ymmtr6/agent-pad/docs/JLCPCB_REPLACEMENT_REV1_CONTINUOUS_20260821.md

# JLCPCB Rev.1 continuous-outline replacement

Target engineer question: `13307549A-Y2`

Upload:

`manufacturing/agentpad_rev1_JLCPCB_panel_replacement_continuous_20260821.zip`

## Correction

- All functional-board and spacer cutting lines are fully connected closed loops.
- No intentional cutting-line gap remains at the former breakaway-tab positions.
- The 152 x 88 mm panel and 68 x 80 mm functional-board dimensions are unchanged.
- Copper, solder mask, paste, silkscreen, and plated-drill files are byte-for-byte identical to the ordered Rev.1 data.
- Only `agentpad_rev1_panel-Edge_Cuts.gbr` is replaced.
- Switch, encoder, RP2040-Zero, and spacer openings are unchanged.

Because the customer data no longer contains retention gaps, JLCPCB CAM should add any temporary production retention tabs needed during routing.

## Validation

- KiCad 9.0.8 standard DRC: lower PCB 0 violations / 0 unconnected; upper PCB 0 violations / 0 unconnected.
- Generator geometry checks: PASS.
- Edge-Cuts graph: 3,080 segments, 64 closed components, 0 odd-degree vertices, 0 duplicate segments.
- ZIP integrity: PASS (8 files).
- SHA-256: `3aede9918c3693d0929e213fe15ce22cecbfcb6f1535e165b50939c38517ad8c`

Final manufacturability remains subject to JLCPCB CAM approval.
