ymmtr6/agent-pad/firmware/readme_rev3.md

# QMK wiring

Direct GPIOs: GP0..GP5 = K1..K6, GP8 = encoder A, GP14 = encoder B, GP15 = encoder push.
All inputs active-low with internal pull-ups.
On-board RP2040-Zero RGB is GPIO16.
