ymmtr6/agent-pad/docs/images/rev2_kicad_bottom.png

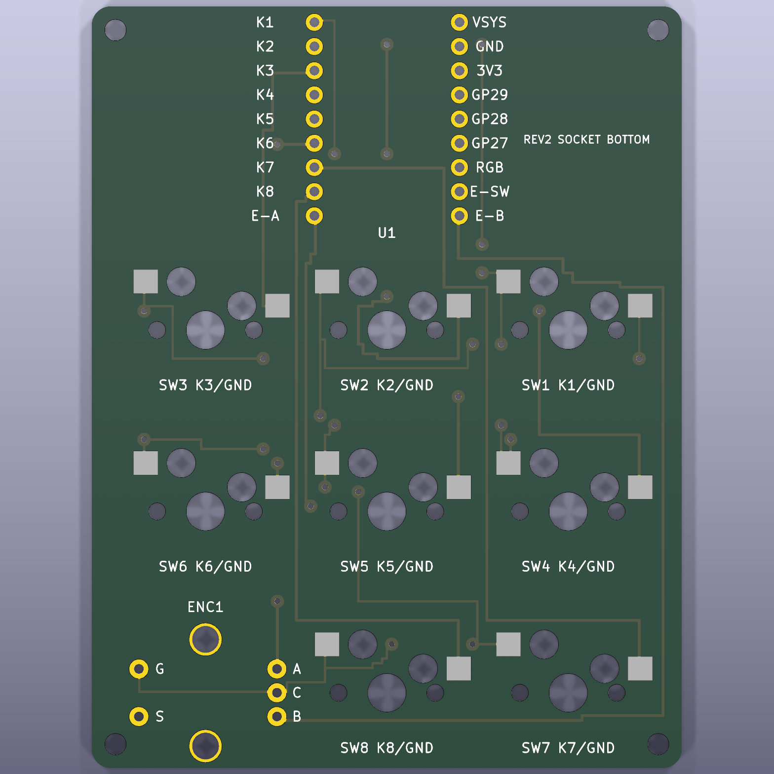
docs/images/rev2_kicad_bottom.png
