ymmtr6/agent-pad/docs/images/rev2_kicad_perspective.png

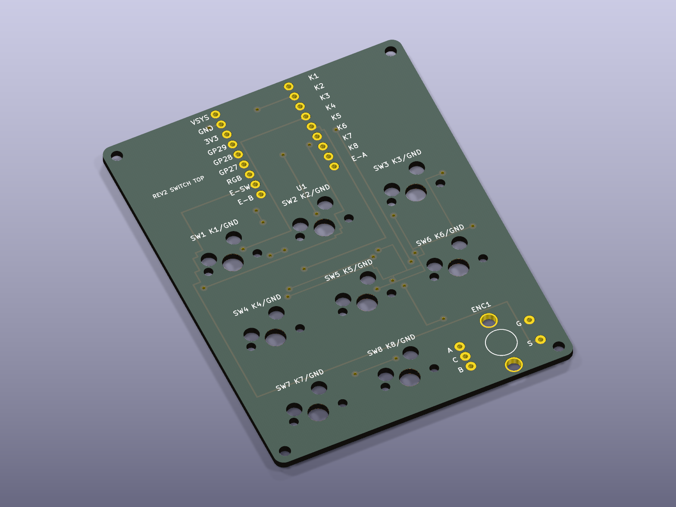
docs/images/rev2_kicad_perspective.png
