ymmtr6/agent-pad/cad/keycap_cherry_mx/agentpad_sw2_task2.stl

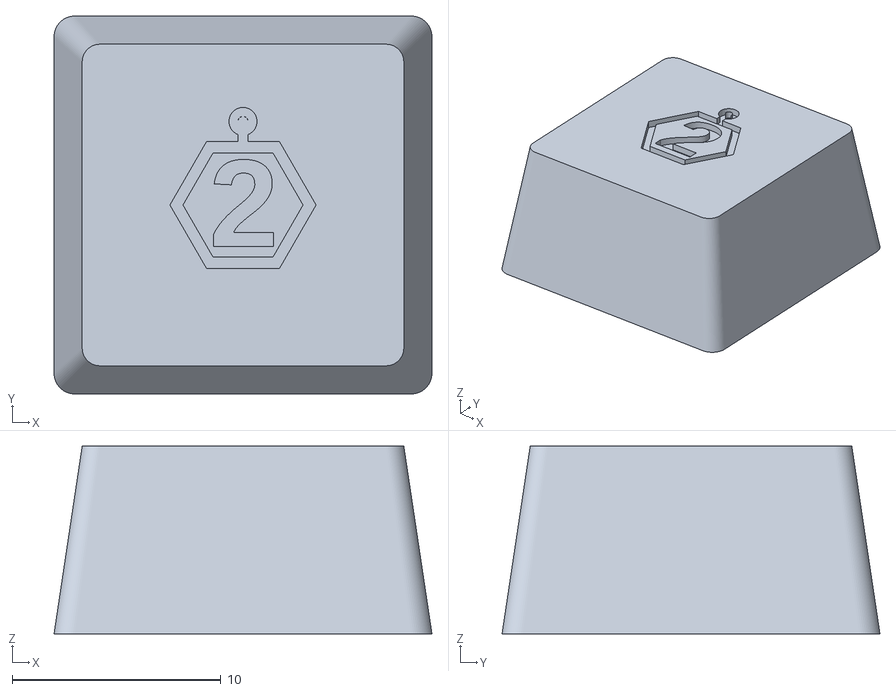
[picture p4: CAD file, 2026-10-14]
cad/keycap_cherry_mx/agentpad_sw2_task2.stl
18.1 x 18.1 x 9.00
