ymmtr6/agent-pad/cad/rev2_case/insert_test.stl

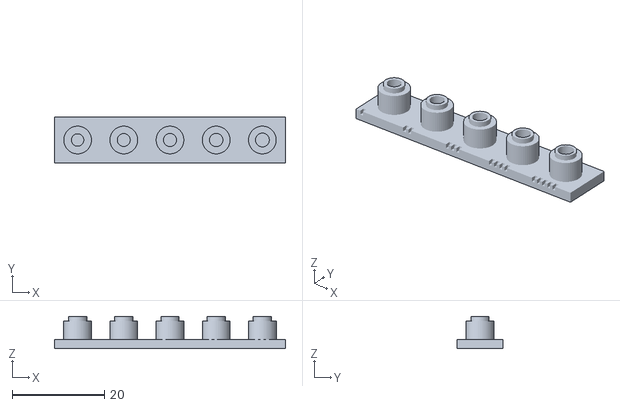
[picture p5: CAD file, 2026-10-14]
cad/rev2_case/insert_test.stl
50.0 x 10.0 x 7.00
