ymmtr6/agent-pad/cad/rev2_case/plate_fit_test.stl

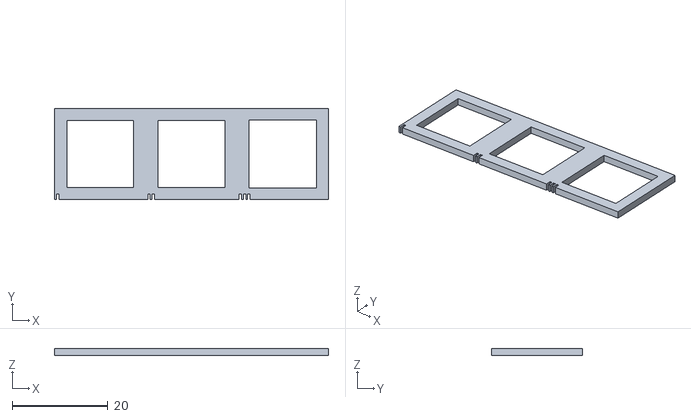
[picture p6: CAD file, 2026-10-14]
cad/rev2_case/plate_fit_test.stl
57.1 x 19.0 x 1.50
