ymmtr6/agent-pad/cad/rev2_case/plate.stl

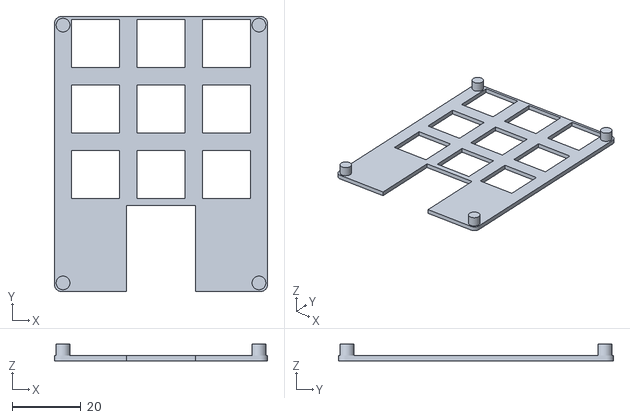
[picture p7: CAD file, 2026-10-14]
cad/rev2_case/plate.stl
62.0 x 80.0 x 4.80
