ymmtr6/agent-pad/cad/rev2_case/bottom_insert.stl

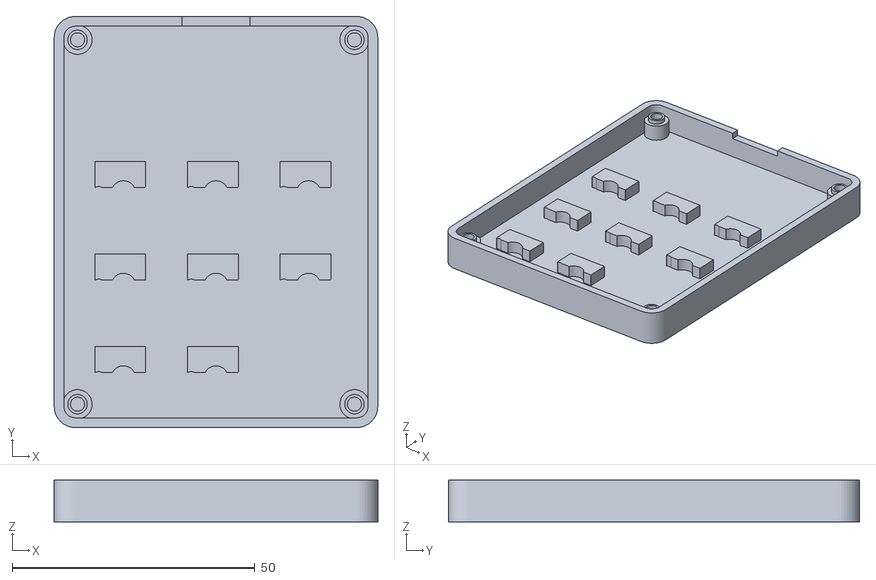
[picture p8: CAD file, 2026-10-14]
cad/rev2_case/bottom_insert.stl
66.6 x 84.6 x 8.60
