ymmtr6/agent-pad/cad/keycap_cherry_mx/agentpad_keyset_8.stl

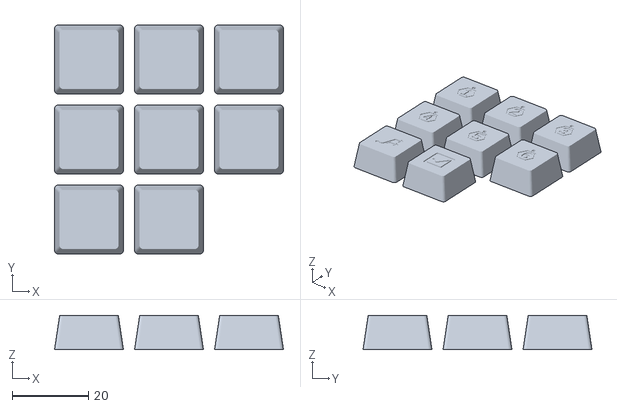
[picture p9: CAD file, 2026-10-14]
cad/keycap_cherry_mx/agentpad_keyset_8.stl
60.1 x 60.1 x 9.00
