ymmtr6/agent-pad/cad/keycap_cherry_mx/cherry_mx_fit_test.stl

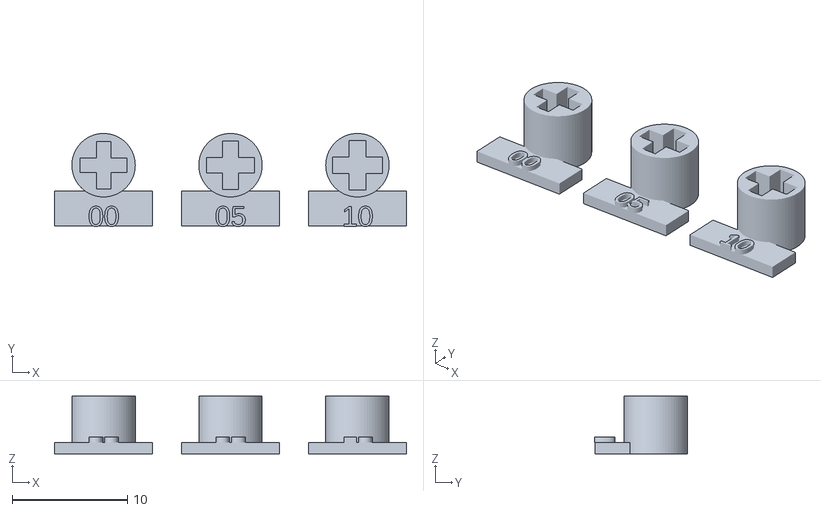
[picture p10: CAD file, 2026-10-14]
cad/keycap_cherry_mx/cherry_mx_fit_test.stl
30.5 x 8.06 x 5.00
