ymmtr6/agent-pad/(list of files, cad)

Other CAD files:
cad/keycap_cherry_mx/agentpad_sw8_test.stl
cad/keycap_cherry_mx/cherry_mx_1u_blank.stl
cad/keycap_cherry_mx/agentpad_sw3_task3.stl
cad/keycap_cherry_mx/cherry_mx_1u_keycap.stl
cad/rev2_case/bottom.stl
cad/keycap_cherry_mx/agentpad_sw5_task5.stl
cad/keycap_cherry_mx/agentpad_sw6_task6.stl
cad/keycap_cherry_mx/agentpad_sw7_refactor.stl
cad/keycap_cherry_mx/agentpad_sw4_task4.stl
cad/keycap_cherry_mx/agentpad_sw1_task1.stl
