ymmtr6/agent-pad/docs/images/rev2_assembly_case_concept.png

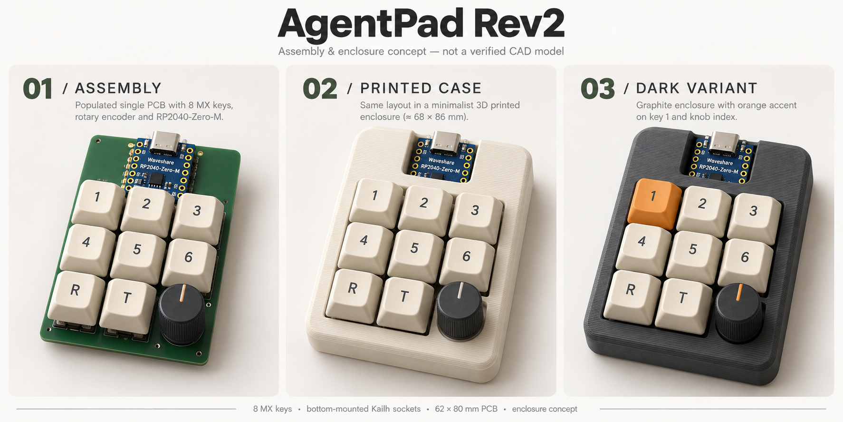
docs/images/rev2_assembly_case_concept.png
