ymmtr6/agent-pad/docs/VALIDATION_REV2.md

# AgentPad Rev2 single-PCB validation

- KiCad: 9.0.8
- DRC violations: 0
- Unconnected items: 0
- Generator geometry checks: PASS
- One 62 × 80 mm PCB; no upper FR4 plate, spacer slots, or panel.
- Eight bottom-side sockets: 16 B.Cu/B.Paste pads; 16 Ø3 mm NPTH socket holes.
- Eight Ø3.9878 mm centre holes and sixteen Ø1.75 mm locating holes.
- Four Ø2.2 mm NPTH M2 mounting holes; centres 2.5 mm from adjacent edges.
- Ø4 mm head/boss to copper minimum gaps (H1..H4): [15.718, 14.953, 0.85, 0.797] mm.
- Ø5 mm copper keepouts on both sides; nominal 14 mm component bodies do not overlap screw heads.
- All fabrication layers and both drill files use the same KiCad export coordinates.
- Physical socket fit and enclosure fit have not yet been tested.
