ymmtr6/agent-pad/kicad/agentpad_rev2_lower.kicad_pcb

## KiCad design kicad/agentpad_rev2_lower.kicad_pcb (2026-10-14, an earlier design)

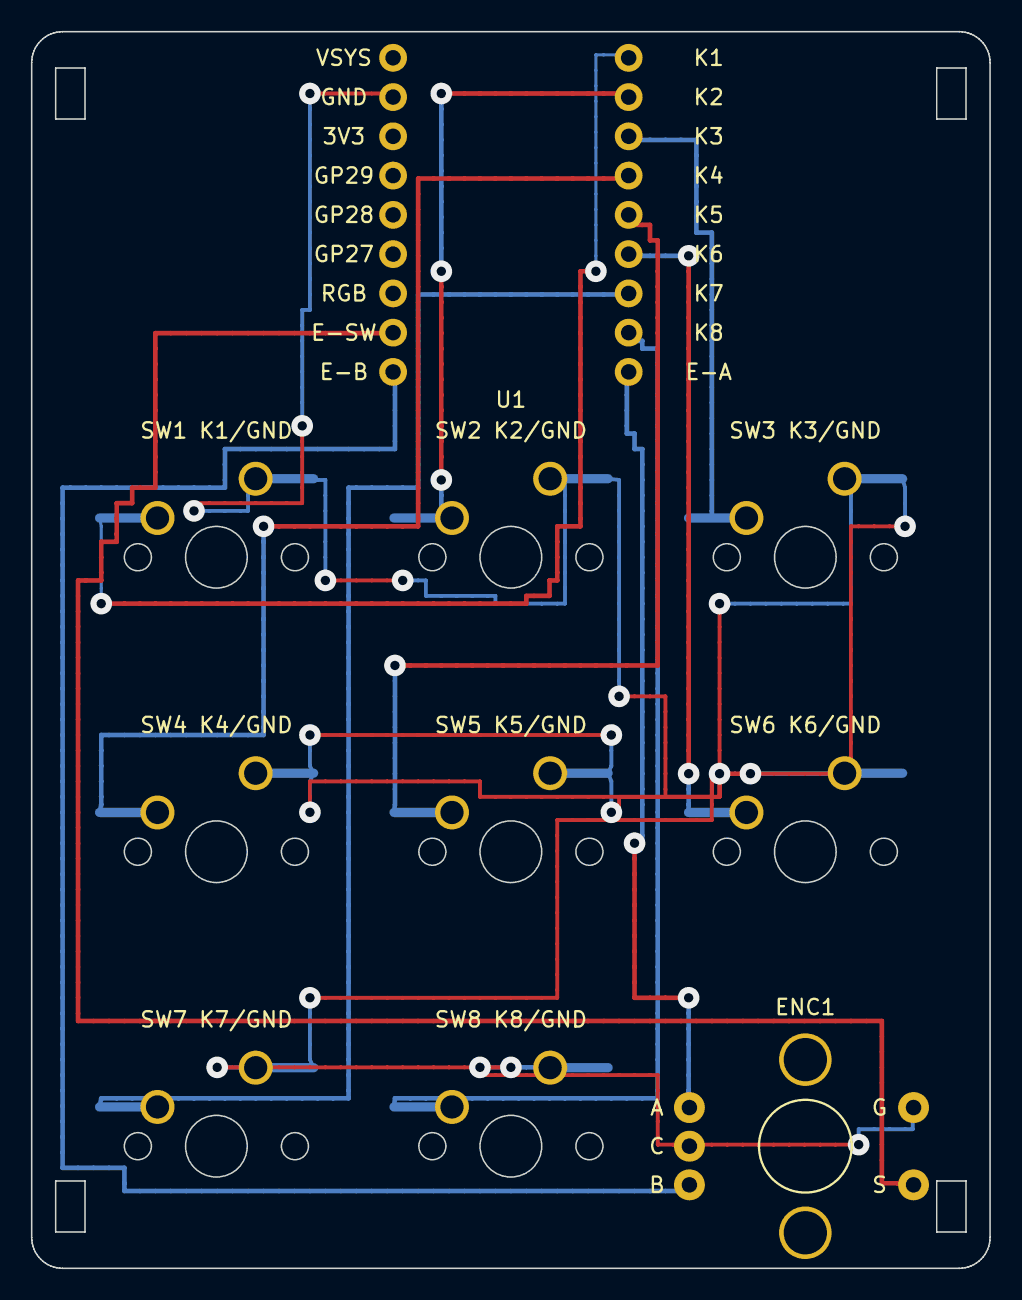
[picture p12: board agentpad_rev2_lower.kicad_pcb from above]

Board: 2 copper layers, 62.0 x 80.0 mm, 10 parts (0 on the bottom side), 12 nets.

Parts:
ENC1: EC11E push encoder; RotaryEncoder_Alps_EC11E-Switch_Vertical_H20mm
SW1, SW2, SW3, SW4, SW5, SW6, SW7, SW8: Kailh MX Hotswap; Kailh_MX_Hotswap_1U
U1: RP2040-Zero-M (visible top); RP2040-Zero-M_Header_Top

Connections:
ENC_A: ENC1.A, U1.9
ENC_B: ENC1.B, U1.15
ENC_SW: ENC1.S1, U1.16
GND: ENC1.C, ENC1.S2, SW1.2, SW2.2, SW3.2, SW4.2, SW5.2, SW6.2, SW7.2, SW8.2, U1.22
K1: SW1.1, U1.1
K2: SW2.1, U1.2
K3: SW3.1, U1.3
K4: SW4.1, U1.4
K5: SW5.1, U1.5
K6: SW6.1, U1.6
K7: SW7.1, U1.7
K8: SW8.1, U1.8
