ymmtr6/agent-pad/scripts/generate_agentpad_rev3.py

"""Generate the compact six-key AgentPad Rev.3 production package."""

import os
import runpy
from pathlib import Path

os.environ["AGENTPAD_REV"] = "3"
os.environ.setdefault("AGENTPAD_PANEL_PROFILE_MODE", "continuous")
runpy.run_path(str(Path(__file__).with_name("generate_agentpad_rev1.py")), run_name="__main__")
