ymmtr6/agent-pad/(commit log)

2026-10-14 Fix Rev2 VIA encoder definition
2026-10-14 Move Rev2 VIA encoder marker to center legend
